WildernessLabs/Circuit_Part_Libraries/README.md

# Circuit_Part_Libraries
Custom libraries for KiCad, Eagle, and other PCB design software.
