WildernessLabs/Circuit_Part_Libraries/Libraries_Kicad/3D_MODELS/CCM Can Shield v5.stp

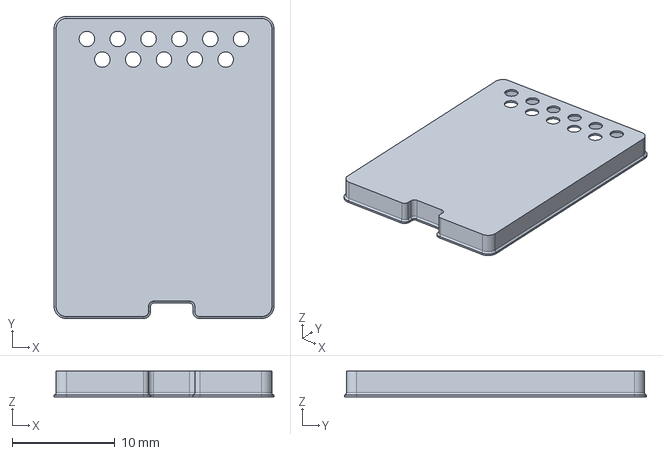
[picture p1: CAD file, 2023-07-25]
Libraries_Kicad/3D_MODELS/CCM Can Shield v5.stp
21.4 x 29.4 x 2.50 mm
