WildernessLabs/Circuit_Part_Libraries/Libraries_Kicad/3D_MODELS/3220-10-0100.igs

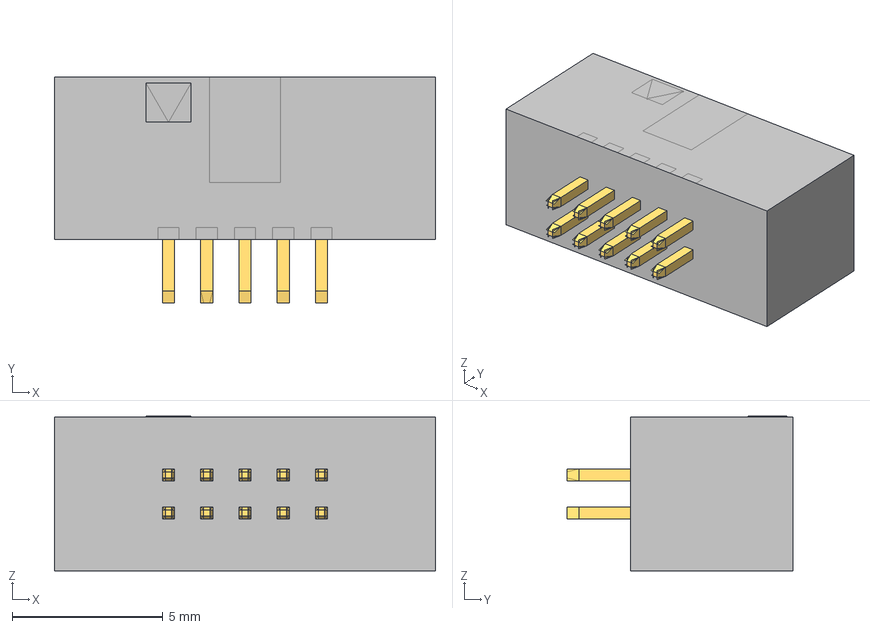
[picture p2: CAD file, 2022-01-24]
Libraries_Kicad/3D_MODELS/3220-10-0100.igs
12.7 x 7.50 x 5.13 mm
