WildernessLabs/Circuit_Part_Libraries/Libraries_Kicad/3D_MODELS/CUI_DEVICES_UJ2-MIBH-G-SMT-TR.step

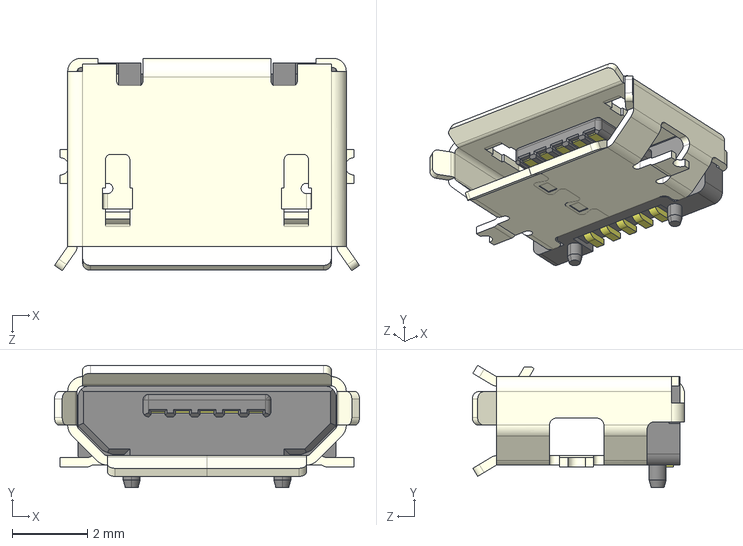
[picture p3: CAD file, 2022-01-15]
Libraries_Kicad/3D_MODELS/CUI_DEVICES_UJ2-MIBH-G-SMT-TR.step
8.10 x 3.25 x 5.64 mm
