WildernessLabs/Circuit_Part_Libraries/Libraries_Kicad/3D_MODELS/WSON-8-6x8mm.STEP

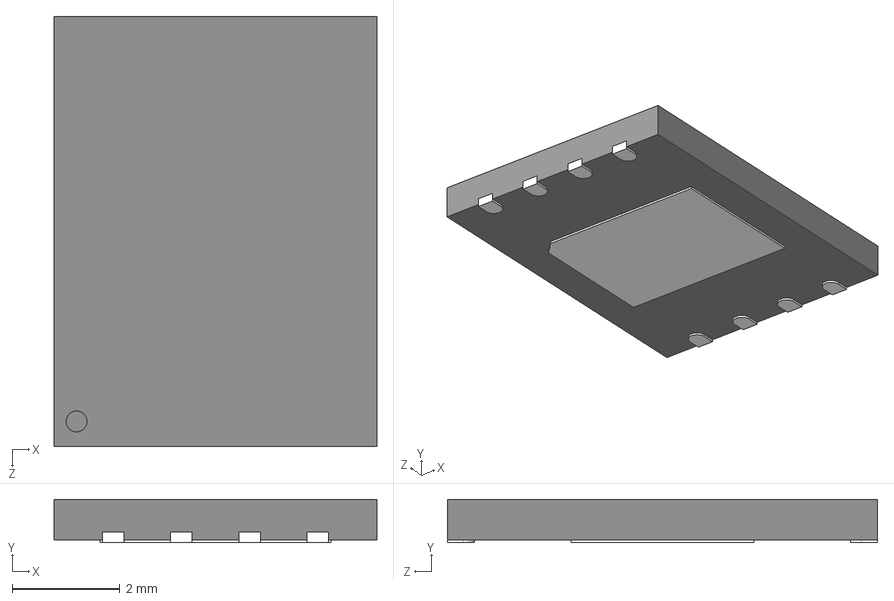
[picture p4: CAD file, 2022-01-15]
Libraries_Kicad/3D_MODELS/WSON-8-6x8mm.STEP
6.00 x 0.8 x 8.00 mm
