WildernessLabs/Circuit_Part_Libraries/Libraries_Kicad/3D_MODELS/QFN56_0_4.STEP

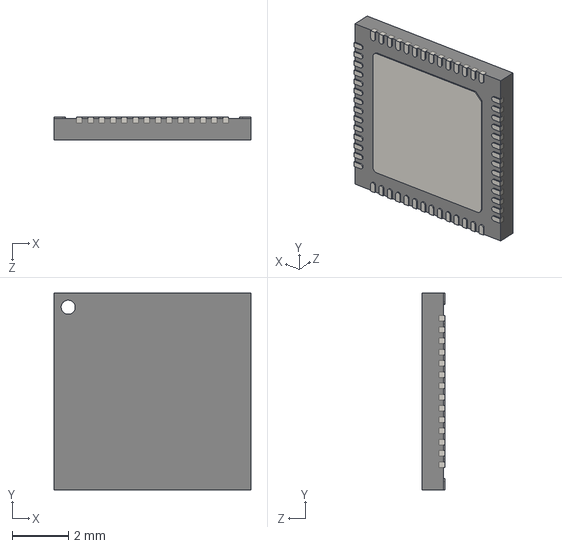
[picture p5: CAD file, 2021-12-31]
Libraries_Kicad/3D_MODELS/QFN56_0_4.STEP
7.00 x 7.00 x 0.8 mm
