WildernessLabs/Circuit_Part_Libraries/Libraries_Kicad/3D_MODELS/DFN-6-1.STEP

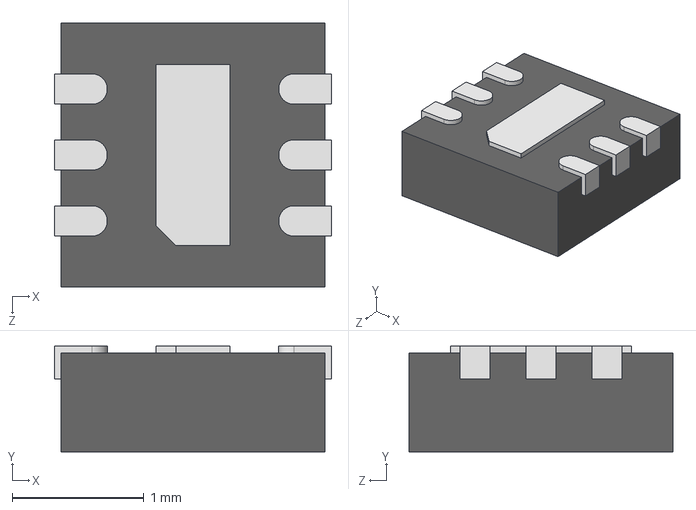
[picture p6: CAD file, 2021-06-06]
Libraries_Kicad/3D_MODELS/DFN-6-1.STEP
2.10 x 0.8 x 2.00 mm
