WildernessLabs/Circuit_Part_Libraries/Libraries_Kicad/3D_MODELS/ECS-80-12-33Q-GN-TR.step

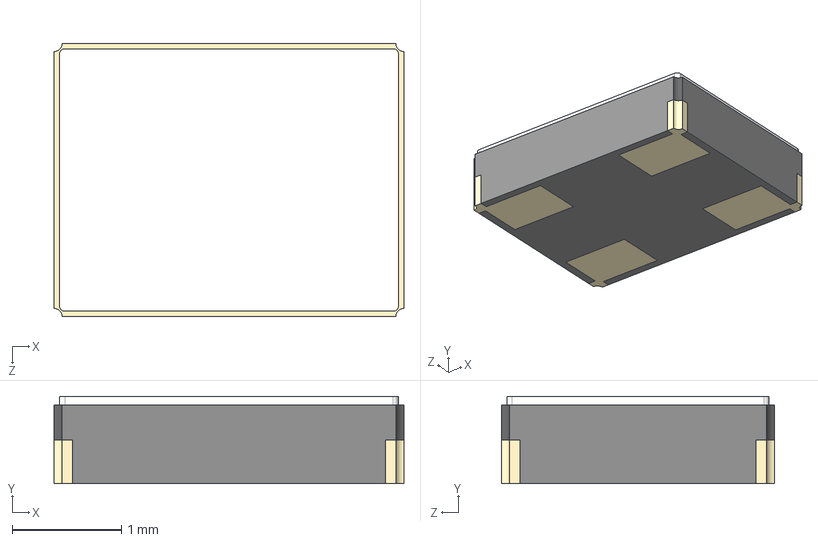
[picture p7: CAD file, 2021-03-29]
Libraries_Kicad/3D_MODELS/ECS-80-12-33Q-GN-TR.step
3.20 x 0.8 x 2.50 mm
