WildernessLabs/Circuit_Part_Libraries/Libraries_Kicad/3D_MODELS/SOT-23-6_M6_MCH.step

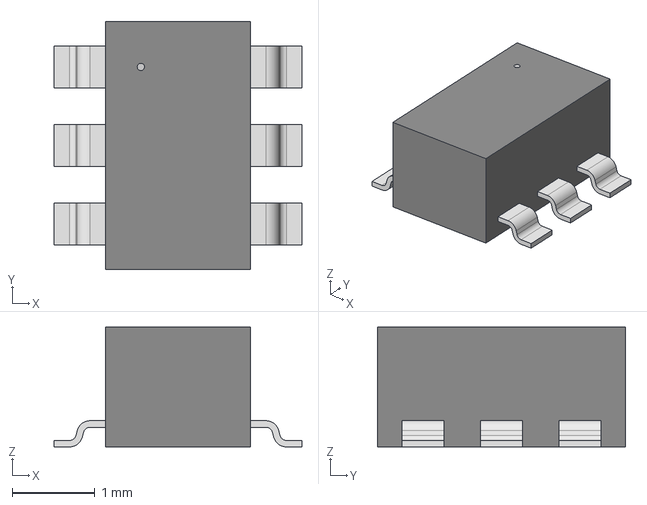
[picture p8: CAD file, 2021-03-29]
Libraries_Kicad/3D_MODELS/SOT-23-6_M6_MCH.step
3.00 x 3.00 x 1.45 mm
