WildernessLabs/Circuit_Part_Libraries/Libraries_Kicad/3D_MODELS/UFQFPN-48_7X7X0P55MM.step

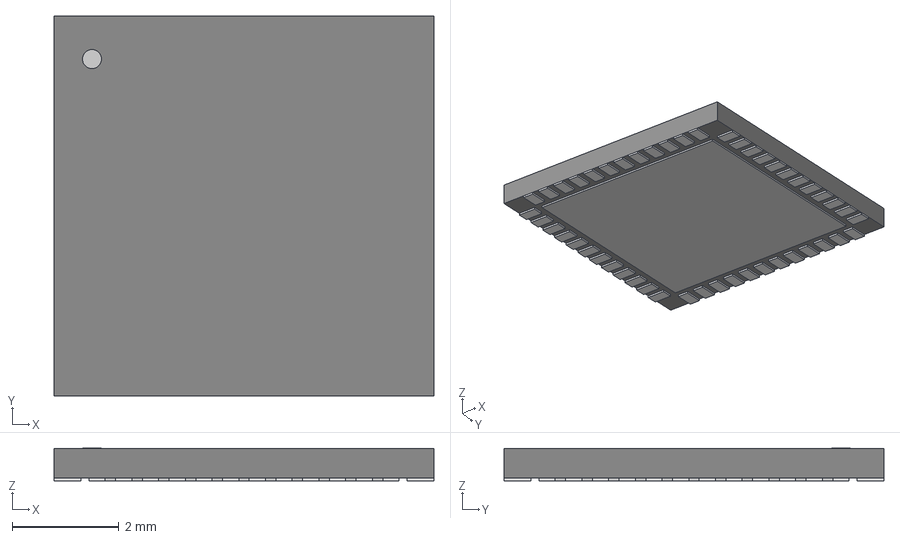
[picture p9: CAD file, 2021-03-27]
Libraries_Kicad/3D_MODELS/UFQFPN-48_7X7X0P55MM.step
7.11 x 7.11 x 0.612 mm
