WildernessLabs/Circuit_Part_Libraries/Libraries_Kicad/3D_MODELS/LTST-C19HE1WT.step

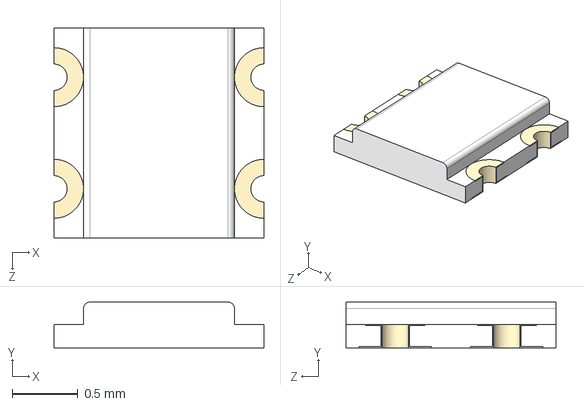
[picture p10: CAD file, 2021-01-20]
Libraries_Kicad/3D_MODELS/LTST-C19HE1WT.step
1.60 x 0.35 x 1.60 mm
