WildernessLabs/Circuit_Part_Libraries/Libraries_Kicad/3D_MODELS/TPS2065CDBVR-2.stp

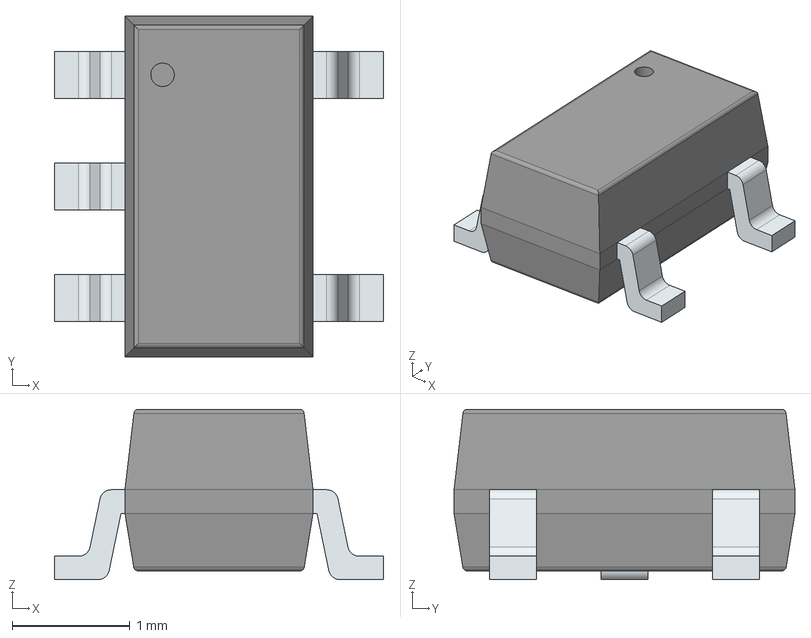
[picture p11: CAD file, 2021-01-13]
Libraries_Kicad/3D_MODELS/TPS2065CDBVR-2.stp
2.80 x 2.90 x 1.45 mm
PinsArrayL
PinsArrayR
