WildernessLabs/Circuit_Part_Libraries/Libraries_Kicad/3D_MODELS/S2B-PH-SM4-TB_LF__SN_.step

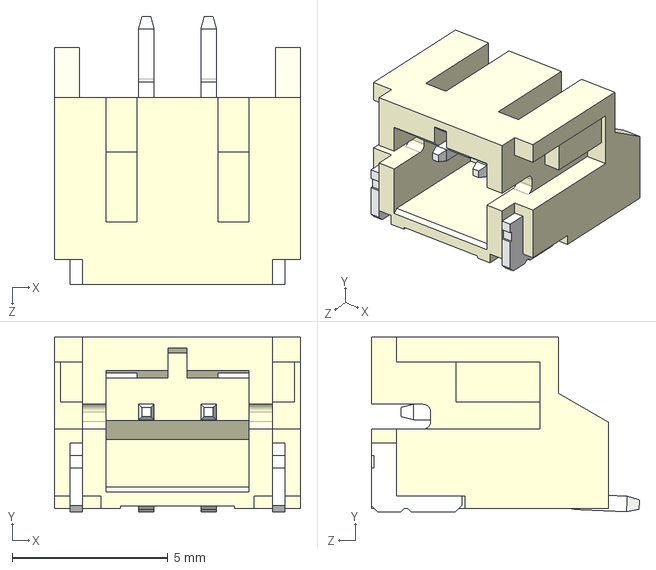
[picture p12: CAD file, 2021-01-13]
Libraries_Kicad/3D_MODELS/S2B-PH-SM4-TB_LF__SN_.step
7.90 x 5.60 x 8.60 mm
