WildernessLabs/Circuit_Part_Libraries/Libraries_Kicad/3D_MODELS/TRANS_RV1C001Z_ROM.step

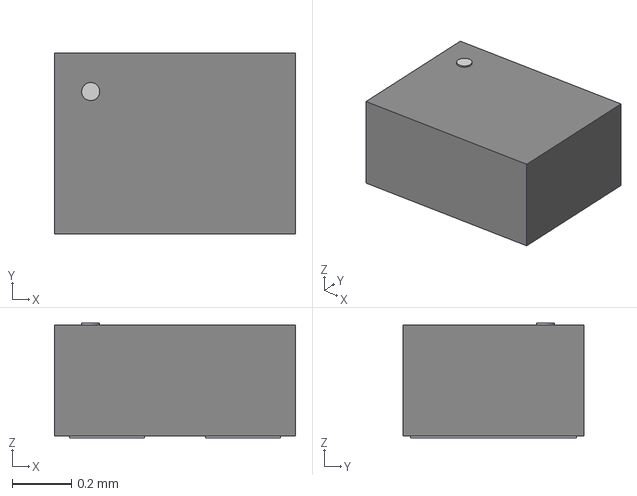
[picture p13: CAD file, 2021-01-13]
Libraries_Kicad/3D_MODELS/TRANS_RV1C001Z_ROM.step
0.812 x 0.61 x 0.387 mm
