WildernessLabs/Circuit_Part_Libraries/Libraries_Kicad/3D_MODELS/ZX62-AB-5PA.stp

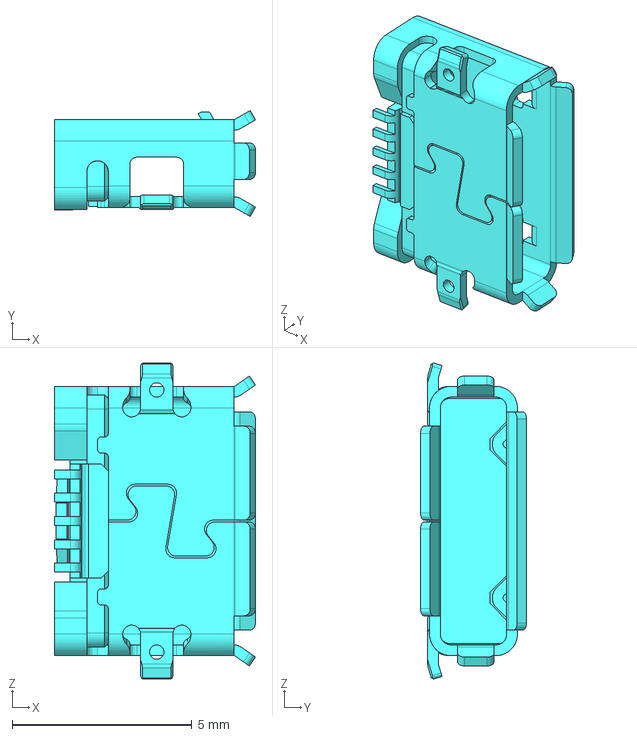
[picture p14: CAD file, 2021-01-13]
Libraries_Kicad/3D_MODELS/ZX62-AB-5PA.stp
5.60 x 2.95 x 8.80 mm
