WildernessLabs/Circuit_Part_Libraries/Libraries_Kicad/3D_MODELS/RWB0012A.stp

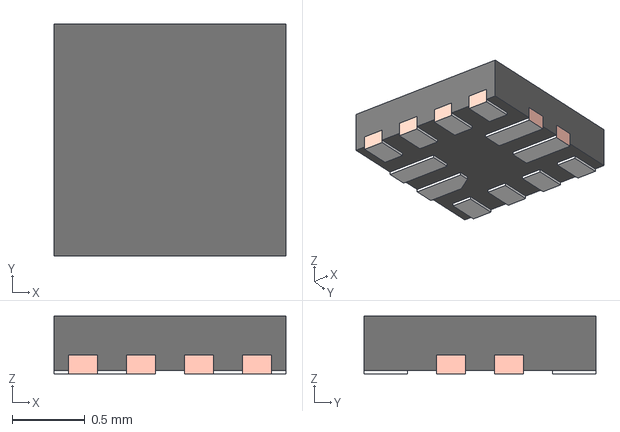
[picture p15: CAD file, 2021-01-13]
Libraries_Kicad/3D_MODELS/RWB0012A.stp
1.60 x 1.60 x 0.4 mm
FRAME-RWB0012A
BODY-QFN
