WildernessLabs/Circuit_Part_Libraries/Libraries_Kicad/3D_MODELS/CST3B_z90.stp

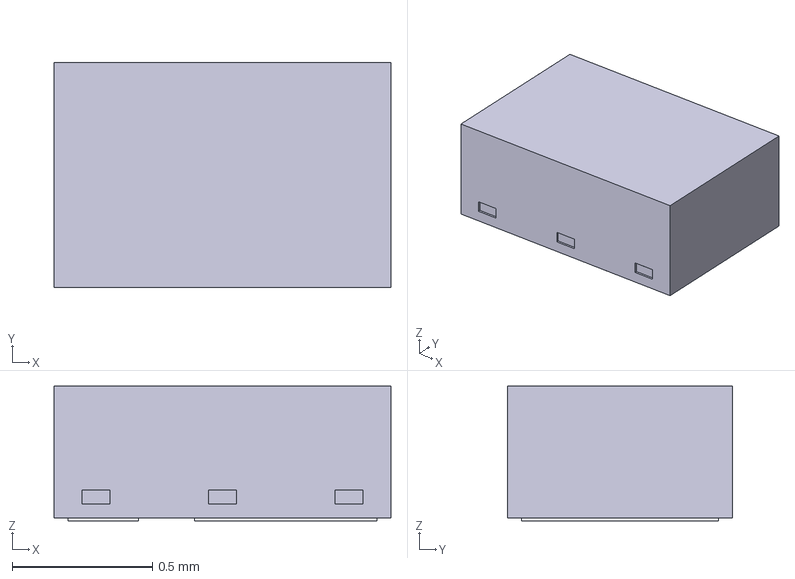
[picture p16: CAD file, 2021-01-13]
Libraries_Kicad/3D_MODELS/CST3B_z90.stp
1.20 x 0.8 x 0.48 mm
