WildernessLabs/Circuit_Part_Libraries/Libraries_Kicad/3D_MODELS/USB4110-GF-A.stp

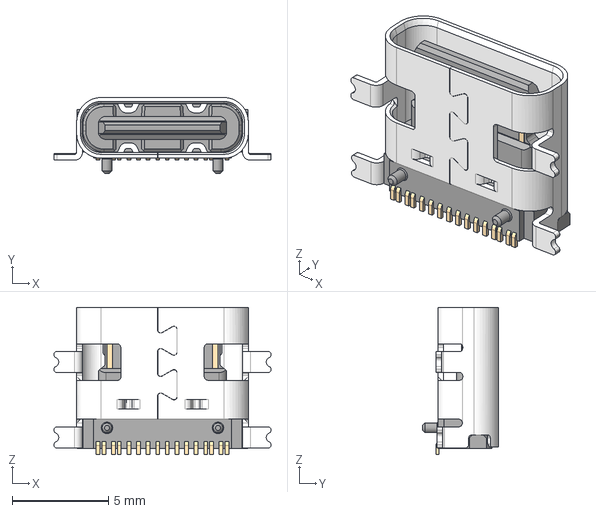
[picture p17: CAD file, 2021-01-06]
Libraries_Kicad/3D_MODELS/USB4110-GF-A.stp
11.3 x 3.96 x 7.68 mm
