WildernessLabs/Circuit_Part_Libraries/Libraries_Kicad/3D_MODELS/FLE-105-01-G-DV-A.stp

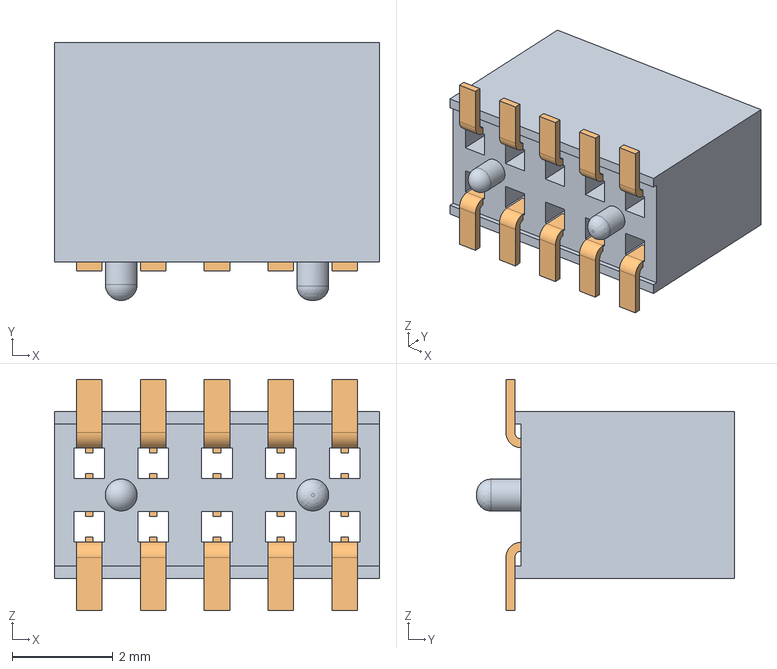
[picture p18: CAD file, 2020-12-14]
Libraries_Kicad/3D_MODELS/FLE-105-01-G-DV-A.stp
6.46 x 5.13 x 4.59 mm
_FLE-105-01-DV-A_socket
_C-96-01-05-DV
