WildernessLabs/Circuit_Part_Libraries/Libraries_Kicad/3D_MODELS/STL6P3LLH6.step

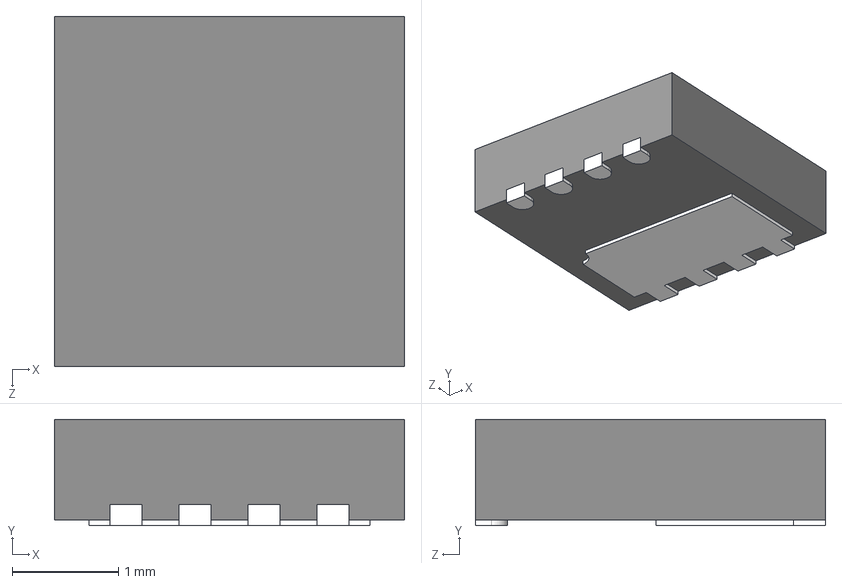
[picture p19: CAD file, 2020-11-08]
Libraries_Kicad/3D_MODELS/STL6P3LLH6.step
3.30 x 1 x 3.30 mm
