WildernessLabs/Circuit_Part_Libraries/Libraries_Kicad/3D_MODELS/USB-A-S-F-W-TH.stp

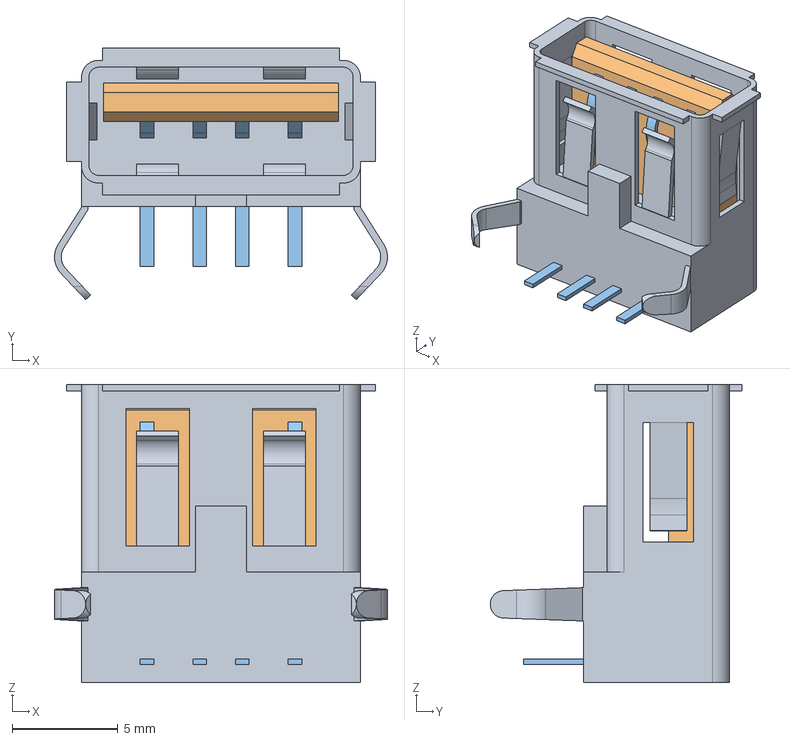
[picture p20: CAD file, 2020-11-02]
Libraries_Kicad/3D_MODELS/USB-A-S-F-W-TH.stp
15.7 x 11.9 x 14.1 mm
_USB-A-S-TH_S
_USB-A-S-W-TH_B
_USB-A-S-TH_P
