WildernessLabs/Circuit_Part_Libraries/Libraries_Kicad/3D_MODELS/RGY0014A.stp

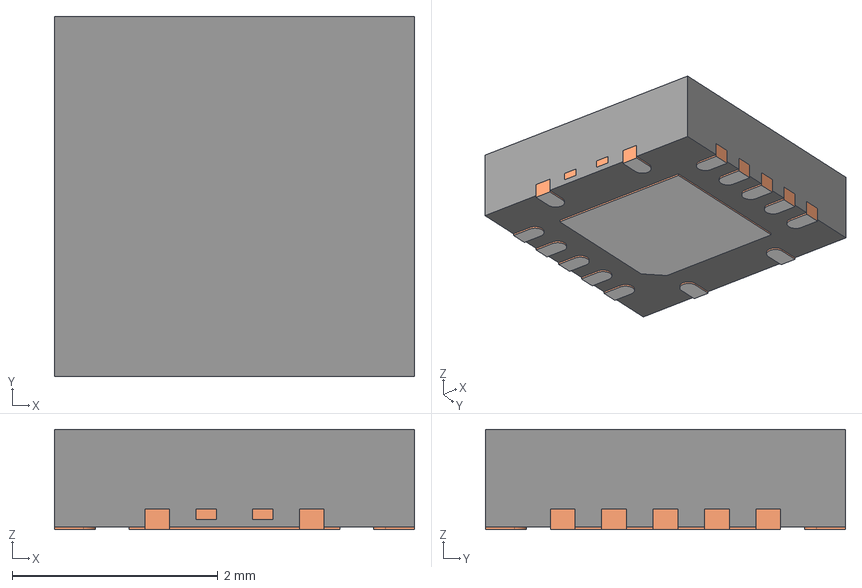
[picture p21: CAD file, 2020-10-26]
Libraries_Kicad/3D_MODELS/RGY0014A.stp
3.50 x 3.50 x 0.975 mm
BODY-QFN
FRAME-RWA0014A
PIN1-ID
