WildernessLabs/Circuit_Part_Libraries/Libraries_Kicad/3D_MODELS/QFN64_9x9MC_MCH.step

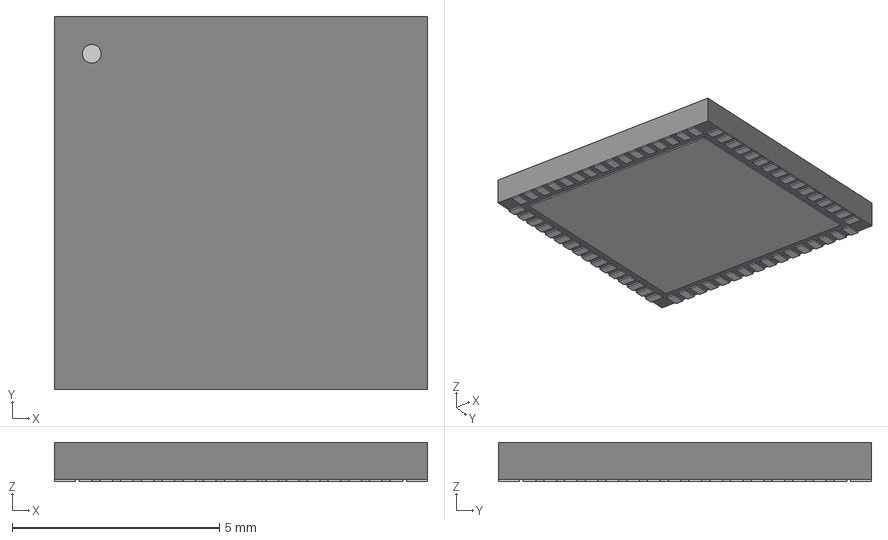
[picture p22: CAD file, 2020-10-10]
Libraries_Kicad/3D_MODELS/QFN64_9x9MC_MCH.step
8.99 x 8.99 x 0.942 mm
