WildernessLabs/Circuit_Part_Libraries/Libraries_Kicad/3D_MODELS/QFN88.STEP

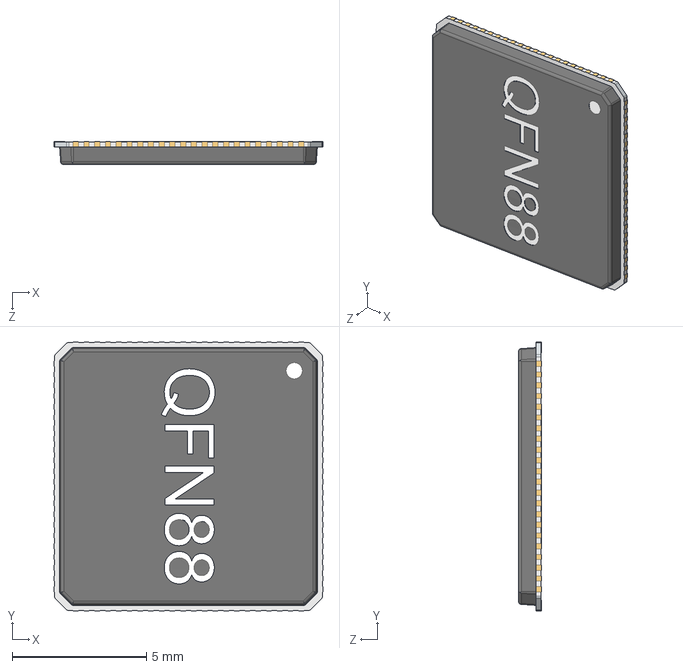
[picture p23: CAD file, 2020-06-24]
Libraries_Kicad/3D_MODELS/QFN88.STEP
10.0 x 10.0 x 0.87 mm
