WildernessLabs/Circuit_Part_Libraries/Libraries_Kicad/3D_MODELS/CK-KMR2.STEP

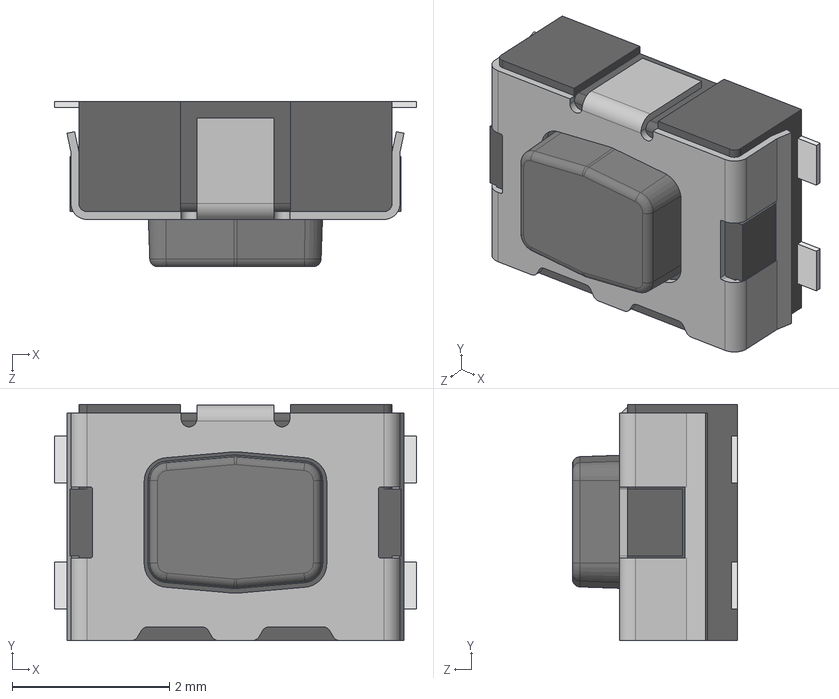
[picture p24: CAD file, 2020-06-24]
Libraries_Kicad/3D_MODELS/CK-KMR2.STEP
4.60 x 3.00 x 2.10 mm
Button
Boitier
Tole
Pads
