WildernessLabs/Circuit_Part_Libraries/Libraries_Kicad/3D_MODELS/F7MicroEmbed_RevA.step

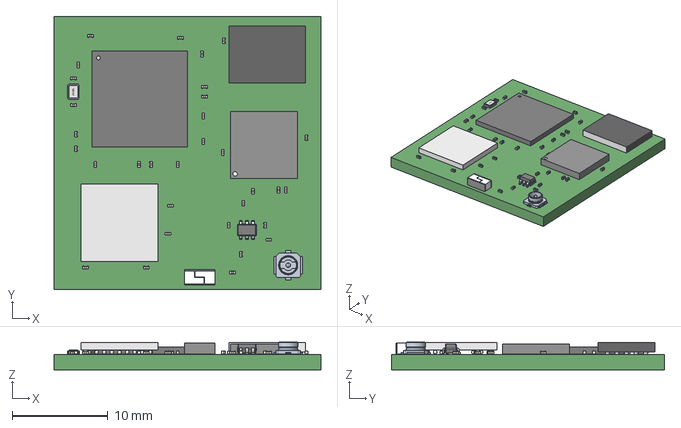
[picture p25: CAD file, 2020-06-24]
Libraries_Kicad/3D_MODELS/F7MicroEmbed_RevA.step
27.9 x 28.6 x 2.91 mm
