WildernessLabs/Circuit_Part_Libraries/Libraries_Kicad/3D_MODELS/User Library-RJ45-01-J0011D01BNL.STEP

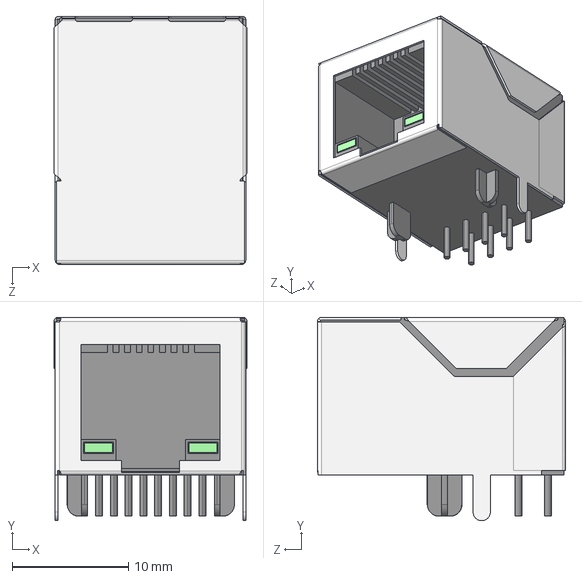
[picture p26: CAD file, 2020-06-24]
Libraries_Kicad/3D_MODELS/User Library-RJ45-01-J0011D01BNL.STEP
16.6 x 17.5 x 21.3 mm
Shield_1
