WildernessLabs/Circuit_Part_Libraries/Libraries_Kicad/3D_MODELS/s2761-46r.stp

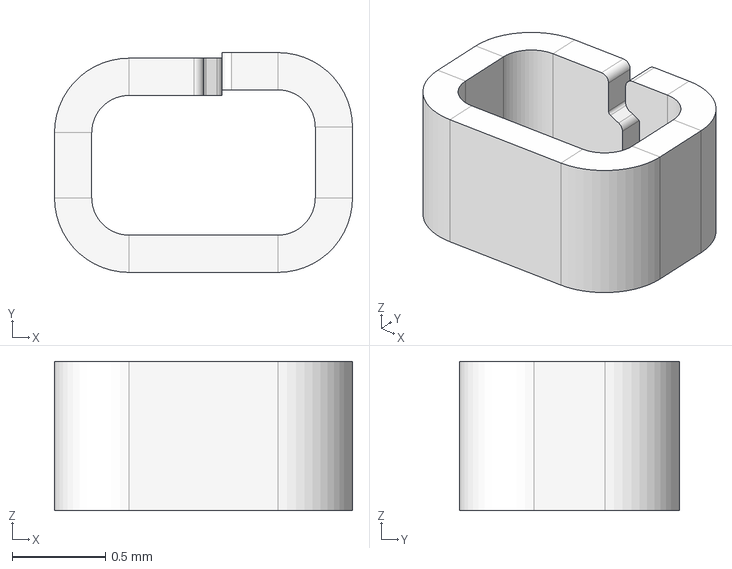
[picture p27: CAD file, 2020-06-24]
Libraries_Kicad/3D_MODELS/s2761-46r.stp
1.60 x 1.18 x 0.8 mm
