WildernessLabs/Circuit_Part_Libraries/Libraries_Kicad/3D_MODELS/FTSH-107-01-L-DV-K-A.stp

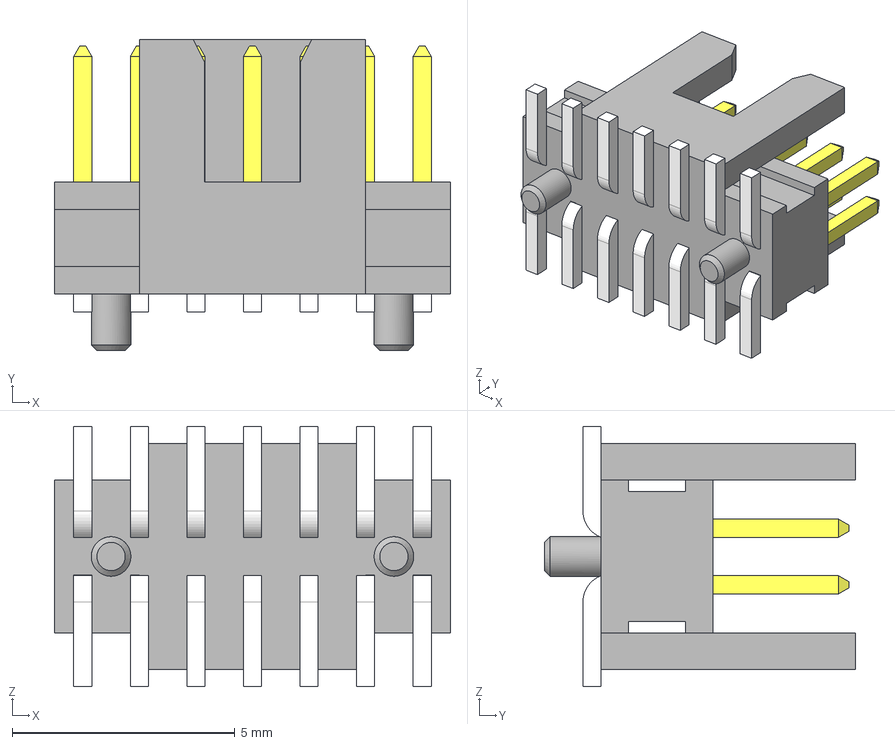
[picture p28: CAD file, 2020-03-27]
Libraries_Kicad/3D_MODELS/FTSH-107-01-L-DV-K-A.stp
8.89 x 6.98 x 5.84 mm
_FTSH-107-01-L-DV-K-A_body
_FTSH-107-01-L-DV-K-A_pins1
_FTSH-107-01-L-DV-K-A_pins2
