WildernessLabs/Circuit_Part_Libraries/Libraries_Kicad/3D_MODELS/8x6BGA_DUAL.step

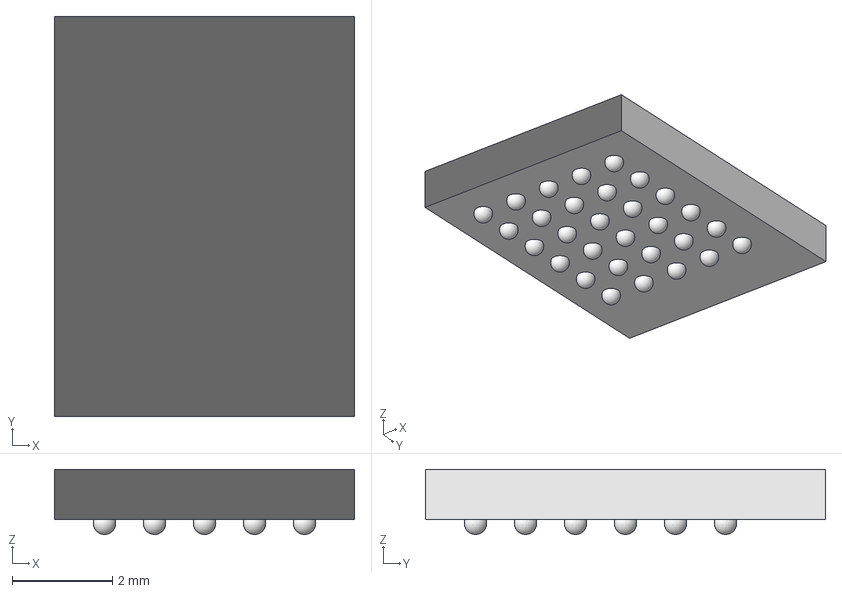
[picture p29: CAD file, 2020-02-27]
Libraries_Kicad/3D_MODELS/8x6BGA_DUAL.step
6.00 x 8.00 x 1.30 mm
