WildernessLabs/Circuit_Part_Libraries/Libraries_Kicad/3D_MODELS/ABM12W.STEP

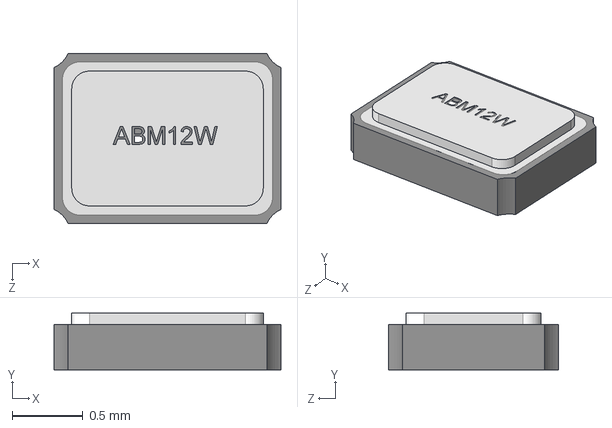
[picture p30: CAD file, 2020-02-27]
Libraries_Kicad/3D_MODELS/ABM12W.STEP
1.60 x 0.4 x 1.20 mm
