WildernessLabs/Circuit_Part_Libraries/Libraries_Kicad/3D_MODELS/ASPI-4030S.STEP

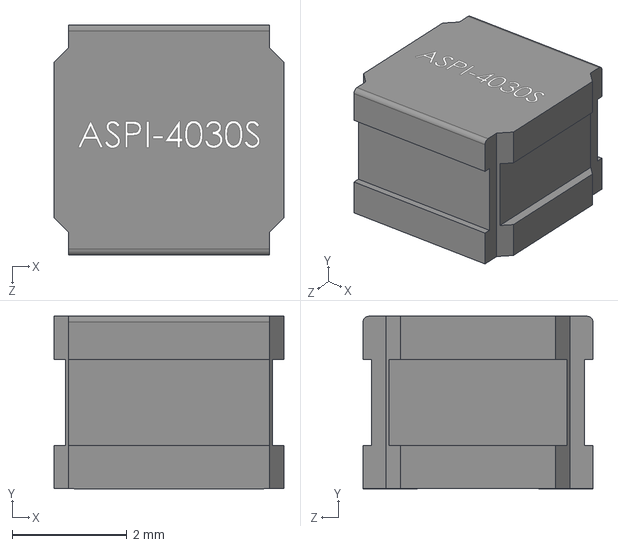
[picture p31: CAD file, 2020-02-27]
Libraries_Kicad/3D_MODELS/ASPI-4030S.STEP
4.00 x 3.00 x 4.00 mm
