WildernessLabs/Circuit_Part_Libraries/Libraries_Kicad/3D_MODELS/W3008--3DModel-STEP-56544.STEP

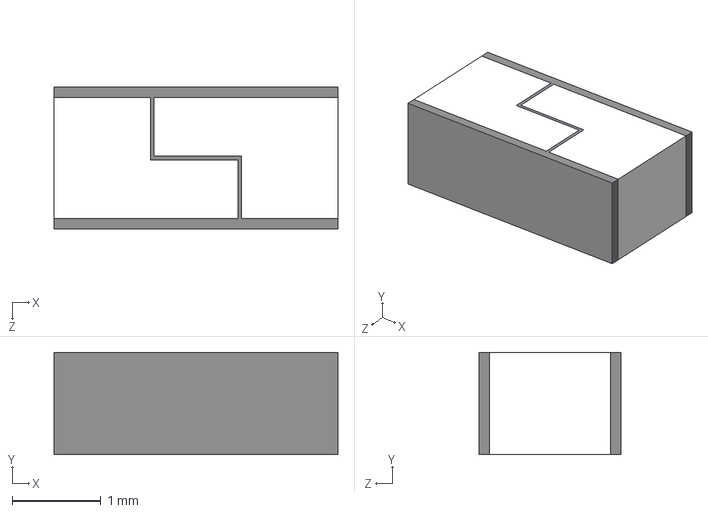
[picture p32: CAD file, 2020-02-27]
Libraries_Kicad/3D_MODELS/W3008--3DModel-STEP-56544.STEP
3.20 x 1.15 x 1.60 mm
