WildernessLabs/Circuit_Part_Libraries/Libraries_Kicad/3D_MODELS/ESP32-PICO-D4--3DModel-STEP-56544.STEP

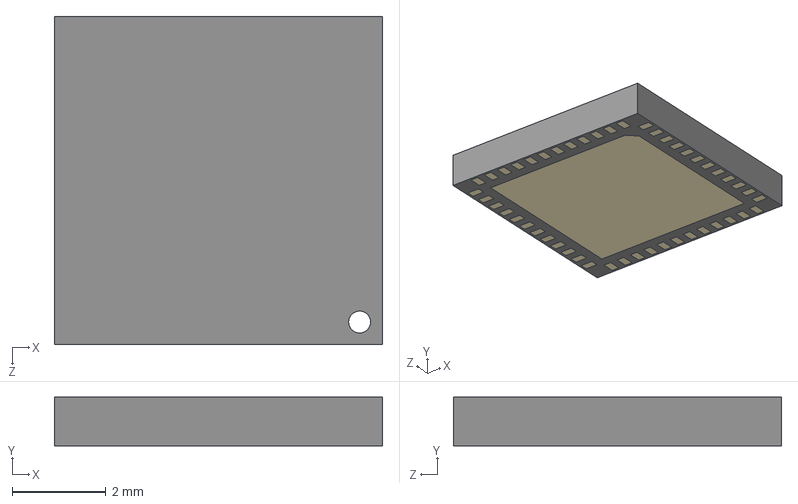
[picture p33: CAD file, 2020-02-27]
Libraries_Kicad/3D_MODELS/ESP32-PICO-D4--3DModel-STEP-56544.STEP
7.00 x 1.04 x 7.00 mm
