WildernessLabs/Circuit_Part_Libraries/Libraries_Kicad/3D_MODELS/a_1jb_3d_model_file.stp

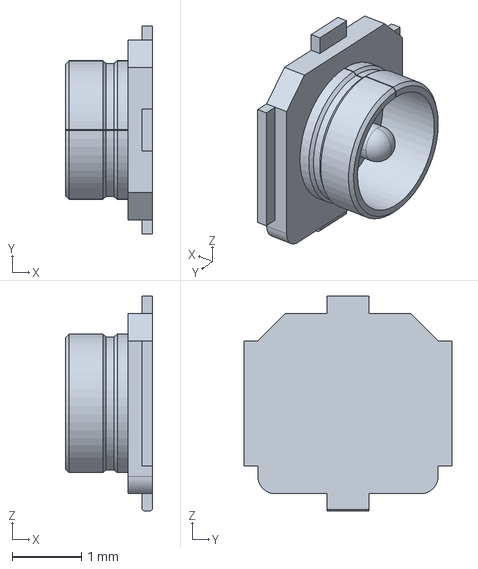
[picture p34: CAD file, 2020-02-27]
Libraries_Kicad/3D_MODELS/a_1jb_3d_model_file.stp
1.25 x 3.00 x 3.10 mm
