WildernessLabs/Circuit_Part_Libraries/(list of files, cad)

Other CAD files:
Libraries_Kicad/3D_MODELS/CCM Can Shield v4.step
Libraries_Kicad/3D_MODELS/Untitled.step
Libraries_Kicad/3D_MODELS/1040310811.stp
Libraries_Kicad/3D_MODELS/434153017835.stp
Libraries_Kicad/3D_MODELS/8X6BGA_DUAL.FCStd
