WildernessLabs/Circuit_Part_Libraries/(commit log)

2020-02-27 Added my libraried to repo
    [54-TFBGA.step, 8X6BGA_DUAL.FCStd, 8x6BGA_DUAL.step, ABM12W.STEP, ASPI-4030S.STEP, ESP32-PICO-D4--3DModel-STEP-56544.STEP, Untitled.step, W3008--3DModel-STEP-56544.STEP]
2020-03-07 added new parts to the lib. Added new libraryies.
    [1040310811.stp]
2020-03-27 Added many parts
    [FTSH-107-01-L-DV-K-A.stp]
2020-06-24 Library update
    [CK-KMR2.STEP, F7MicroEmbed_RevA.step, QFN88.STEP, User Library-RJ45-01-J0011D01BNL.STEP, s2761-46r.stp]
2020-09-26 Added the boarder
2020-10-10 Added parts for bulk programmer
    [QFN64_9x9MC_MCH.step]
2020-10-11 added LED
2020-10-26 Added Kicad parts for Bulk programmer
    [RGY0014A.stp]
2020-11-02 added usb-a
    [USB-A-S-F-W-TH.stp]
2020-11-08 added power circuits
    [STL6P3LLH6.step]
2020-11-09 Added some resistors and Caps
2020-11-22 Updated the EmbedModule Footprint to match new Revision Module
2020-12-14 added connector
    [FLE-105-01-G-DV-A.stp]
2021-01-06 added parts
    [USB4110-GF-A.stp]
2021-01-13 Added parts for V2 meadow
    [CST3B_z90.stp, RWB0012A.stp, ZX62-AB-5PA.stp]
2021-01-13 Added more parts for v2 meadow
    [S2B-PH-SM4-TB_LF__SN_.step, TPS2065CDBVR-2.stp, TRANS_RV1C001Z_ROM.step]
2021-01-18 Added parts for meadow V2
    [434153017835.stp]
2021-01-20 added parts for mirco meadow
    [LTST-C19HE1WT.step]
2021-02-05 added stm32
2021-03-27 Added new MCU for Blackmagic
    [UFQFPN-48_7X7X0P55MM.step]
2021-03-29 added parts for bulk programmer, forgot to add them in last commit
    [ECS-80-12-33Q-GN-TR.step, SOT-23-6_M6_MCH.step]
2021-06-06 updated symbols for micro meadow
    [DFN-6-1.STEP]
2021-12-31 [New Part] ESP32-S3 added to Library
    [QFN56_0_4.STEP]
2021-12-31 Convert libraries to Kicad version 6
2022-01-02 Added parts for ESP32-s3 meadow
2022-01-09 covert last libs to Kicad 6
2022-01-15 Added flash and new micro USB connector to the lib for the ESP32-S3 board
    [CUI_DEVICES_UJ2-MIBH-G-SMT-TR.step, WSON-8-6x8mm.STEP]
2022-01-16 Added ESP32-S3 (feather symbol)
2022-01-17 fixed Resistors with 0603 footprints, added memory and esp32 footprint
2022-03-01 Added new parts for ESP32 and Meadow
2023-07-23 added shield can
    [CCM Can Shield v4.step]
2023-07-25 updated core compute module
    [CCM Can Shield v5.stp]
