WildernessLabs/Circuit_Part_Libraries/(notices)

Notices in the files:
Libraries_Kicad/3D_MODELS/FLE-105-01-G-DV-A.stp:
FILE_NAME( 'p:/temp/worker_154/temp/exporttempdir_3772_1074_R3CB9/format_0/FLE-105-01-G-DV-A.stp', '2020-12-13T23:16:46', ( 'License CC BY-ND 4.0' ), ( 'CADENAS' ), ' ', 'PARTsolutions', ' ' );
Libraries_Kicad/3D_MODELS/USB-A-S-F-W-TH.stp:
FILE_NAME( 'p:/temp/worker_18/temp/exporttempdir_5112_553_efHz9/format_0/USB-A-S-F-W-TH.stp', '2020-11-02T00:24:52', ( 'License CC BY-ND 4.0' ), ( 'CADENAS' ), ' ', 'PARTsolutions', ' ' );
Libraries_Kicad/3D_MODELS/USB4110-GF-A.stp:
FILE_NAME( 'p:/temp/worker_57/temp/exporttempdir_3932_655_ohTl5/format_0/USB4110-GF-A.stp', '2021-01-06T05:26:20', ( 'License CC BY-ND 4.0' ), ( 'CADENAS' ), ' ', 'PARTsolutions', ' ' );
